JoeyShotts/GCODE_Plotter_Polargraph/ElectronicsDiagrams/Electronics.md

# Electronics
I used Nema17 stepper motors, a 9g servo, 3 Buttons, and an OLED screen. You can disable the OLED screen easily if you don't want that feature. One of the buttons is for an estop, the other two allow you to directly run some functions on the arduino, stuff like home, a specific gcode function stored on the arduino, pen up/down. etc. I recommend an Arduino Mega for this project, but an Arduino Uno would likely work, and so would another reasonably powerful microcontroller if you know what you're doing.

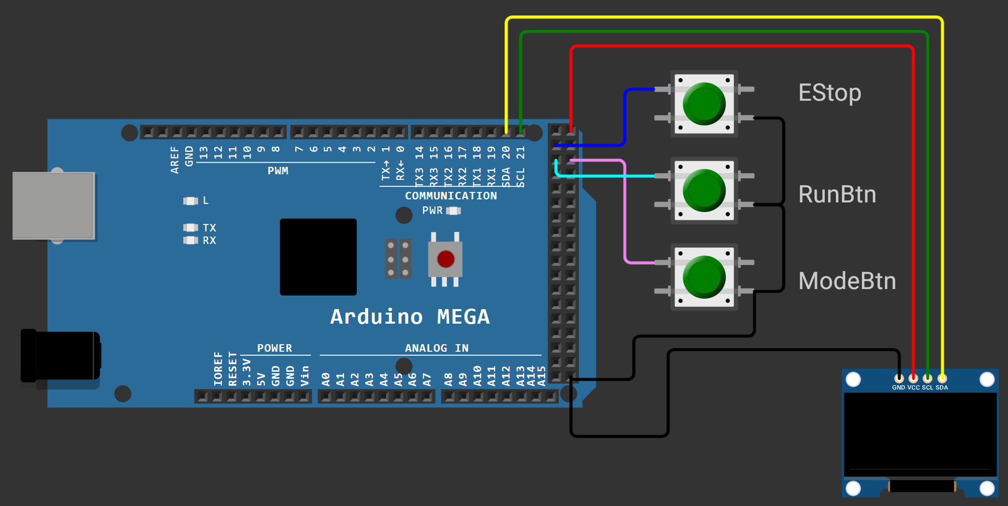
[picture p5: ElectronicsDiagrams/OLED_Buttons.png]
OLED_Buttons


## Motor Driver
This project uses a low cost motor driver. It uses nema17 motors and a knockoff of the AdafruitMotorSheildV1 (This can add some complexity). Some Nema17 motors tend to draw more current than the AdafruitMotorSheildV1 likes to provide. I wired 4 100 Ohm 1/4 watt resistors (in parallel to make 25 Ohms) in series with each coil of the nema17 motors (8 resistors per motor because there are 2 coils per motor). This is not ideal and can be avoided by using a lower current stepper motor (like the one linked below). It would also be relatively trivial to use a different motor driver update the arduino code as the accel steppers library is used. You simply need to update the functions that step each motor forward and backward.

[AdafruitMotorSheildV1 (called L293D driver) Driver](https://www.amazon.com/DiGiYes-Stepper-Expansion-Duemilanove-Raspberry/dp/B0BSN8FTH2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)

You will also need a power supply for the driver. This one is nice, I would set the input voltage to around 9v and then slowly increase as needed, keeping it less than 15v. The link has a power supply with a barrel jack, it also has an adapter with screw terminals need to connect the power supply to the motor driver.

[Barrel Jack Power for Driver](https://www.amazon.com/Adjustable-Universal-Switching-Minidodoca-Electronics/dp/B0C5QG946M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)

## Servo
I used a standard 180 degree 9g servo controlled with a PWM signal. Many motor shields have spots for these, if they don't, you can easily wire the servo directly to the arduino.The AdafruitMotorSheildV1 has a spot for a servo and I plugged in a servo to motor 1. This connects to pin 10. The servo pin and be changed in the penLift.ino file. You will need some kind of servo extenstion or 3 wires to connect the servo to the arduino.

[9g Servo Example](https://www.amazon.com/10Pcs-Servos-Helicopter-Airplane-Controls/dp/B07MLR1498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)

## Push Buttons
It has 3 physical pushbuttons (no hardware debounce or resistors needed). One is an EStop that will stop the machine at any point. Another is used to change a function, see manual functions below to get a list of the functions on the machine. The third will run the currently selected function. These give a user the ability to just run a GCODE file, without any kind of software/usb connection needed. The two change function and run function can be disabled by commenting out the macro MODE_BUTTONS.

Note where the two sides of the buttons are. One side needs to be connected to ground, the other side to a digital input of the arduino. You can change the pins in the arduino in the code easily.

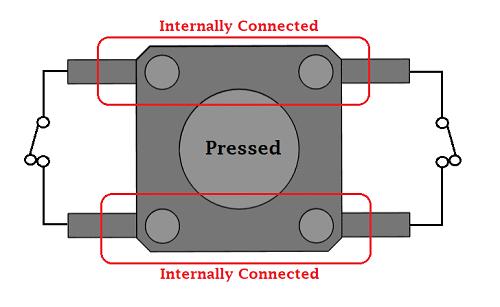
[picture p6: ElectronicsDiagrams/Push-button-Pinout.gif]
Push Button Pinout


[Push Buttons](https://www.amazon.com/Gikfun-12x12x7-3-Tactile-Momentary-Arduino/dp/B01E38OS7K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)

## Small OLED Screen
It also uses a single I2C 0.96 inch common OLED screen (128x64 pixels) to allow for some functions to be run directly on the machine. This is convenient feedback but can be easily disabled with a single MACRO (just comment out the #define OLED in the PolargraphGCODEController.ino file) in the arduino code. To wire up the OLED there are 4 pins, GND, +Vcc (typically 5 volts is preferred but 3.3 will work), SCL and SDA. SCL and SDA can only be on specific pins. Just look up the I2C pins of the microcontroller you're using. On an Arduino Mega SCL is digital pin 21 and SDA is digital pin 20.

Occasionally these OLED screens will have a different address than normal and if you've double checked the wiring and it still isn't working, check the OLED.ino file, look for the address 0x3C and change it to 0x3D.

[OLED Example Link](https://www.amazon.com/Hosyond-Display-Self-Luminous-Compatible-Raspberry/dp/B0BFD4X6YV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)

## Stepper Diagram
Different Nema17 steppers can be wired differently and have different current draws so be careful. Many have colored wires that line up with the diagram below as follows:
Green and Red are paired
Black and Blue are paired

1a: Red
2b: Blue
1b: Green
2a: Black

You can check if two wires are connected through a coil by seeing if a multimeter has no resistance over those two wires. Ex: Red and Green wires (with one wire connected to black test probe and the other connected to the red test probe) should show no resistance.

When using the AdafruitMotorSheildV1 each coil is connected to a different motor. (There are two screw terminals per motor). Ex: M1 should have 1a and 1b connected. M2 should have 2a and 2b connected. M3 might have 1a and 1b of another motor, etc.

[Stepper Motor Link](https://www.amazon.com/BESJMYT-Stepper-0-80inch-Engraving-1-66x1-66x0-81inch/dp/B0D22GZFPC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)

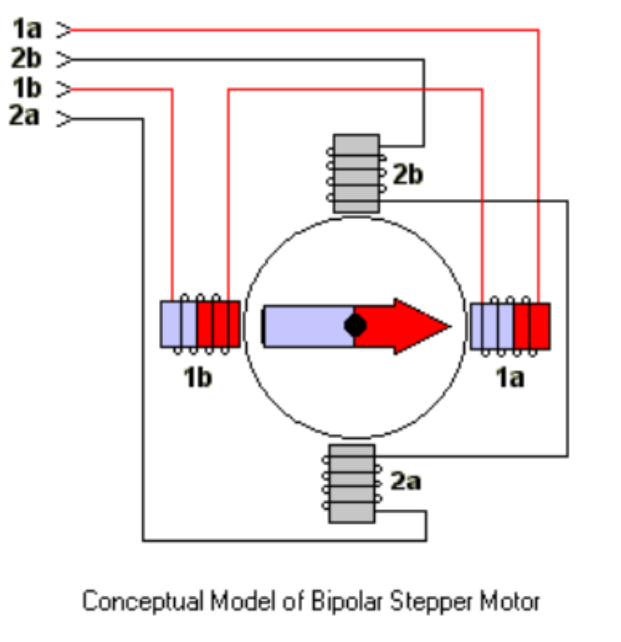
[picture p7: ElectronicsDiagrams/Nema17BipolarDiagram.png]
Nema17 Bipolar Stepper Diagram
