JoeyShotts/GCODE_Plotter_Polargraph/3D Models and Components/3D_Files/MotorBracketV5 - GongolaAlignmentClipV2.stl

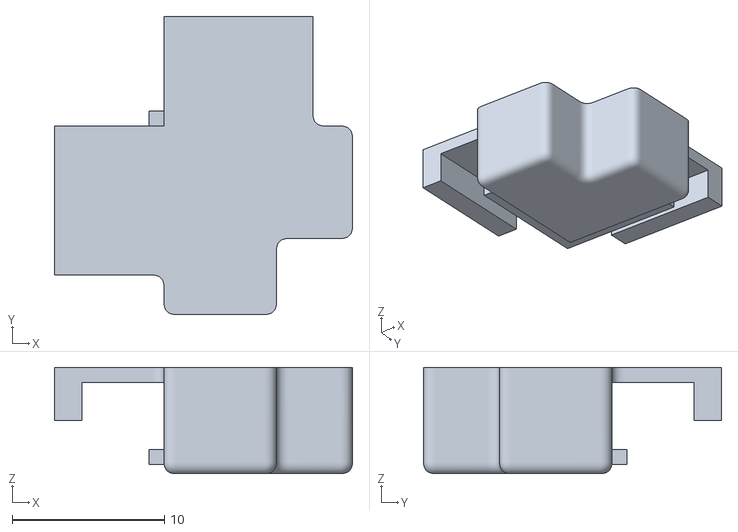
[picture p13: CAD file, 2025-09-12]
3D Models and Components/3D_Files/MotorBracketV5 - GongolaAlignmentClipV2.stl
19.6 x 19.6 x 7.00
