JoeyShotts/GCODE_Plotter_Polargraph/3D Models and Components/3D_Files/MotorBracketV5 - MotorBracketR.stl

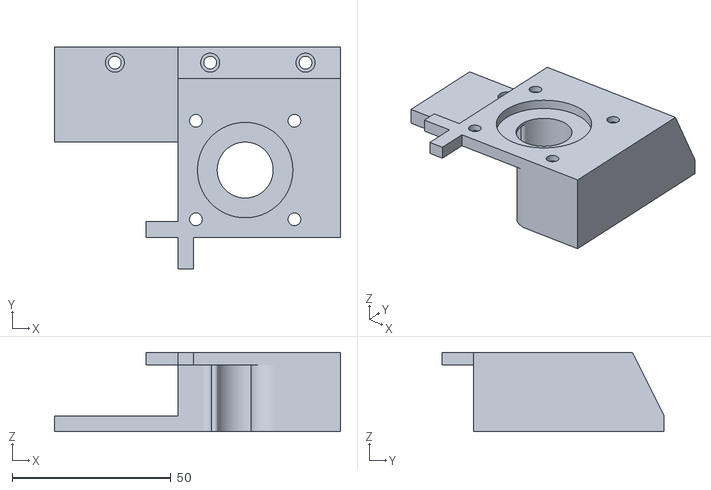
[picture p14: CAD file, 2025-06-21]
3D Models and Components/3D_Files/MotorBracketV5 - MotorBracketR.stl
90.0 x 70.0 x 25.0
