JoeyShotts/GCODE_Plotter_Polargraph/3D Models and Components/3D_Files/ElectronicsBase - Part 1.stl

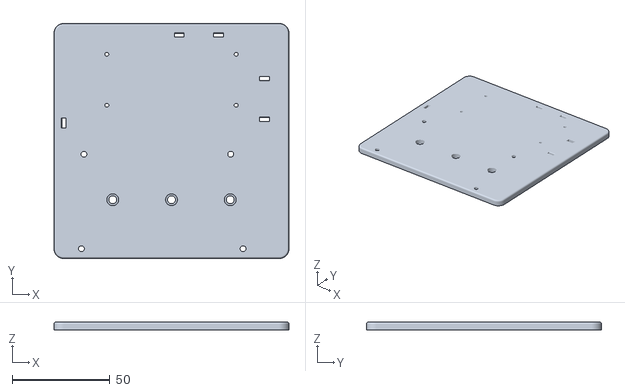
[picture p15: CAD file, 2025-06-21]
3D Models and Components/3D_Files/ElectronicsBase - Part 1.stl
120.0 x 120.0 x 4.00
