JoeyShotts/GCODE_Plotter_Polargraph/3D Models and Components/3D_Files/MotorBracketV5 - MotorClipR.stl

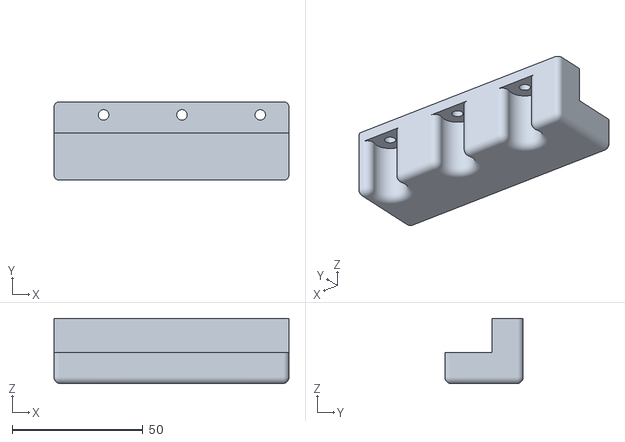
[picture p16: CAD file, 2025-06-21]
3D Models and Components/3D_Files/MotorBracketV5 - MotorClipR.stl
90.0 x 30.0 x 25.0
