JoeyShotts/GCODE_Plotter_Polargraph/3D Models and Components/3D_Files/SideWeights - PrintTwo.stl

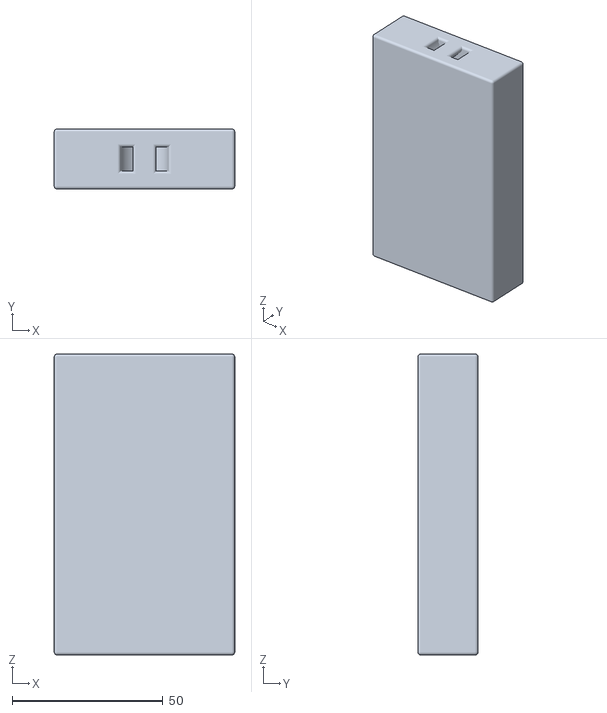
[picture p17: CAD file, 2025-06-21]
3D Models and Components/3D_Files/SideWeights - PrintTwo.stl
60.0 x 20.0 x 100.0
