JoeyShotts/GCODE_Plotter_Polargraph/3D Models and Components/3D_Files/PenHolderAdapter.stl

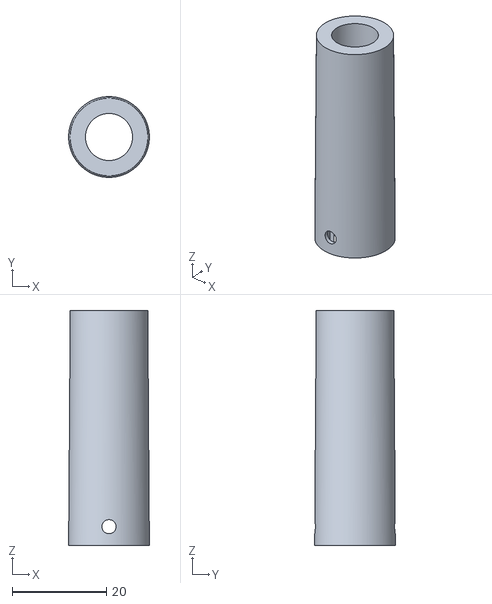
[picture p18: CAD file, 2025-06-21]
3D Models and Components/3D_Files/PenHolderAdapter.stl
17.2 x 17.2 x 50.0
