JoeyShotts/GCODE_Plotter_Polargraph/3D Models and Components/3D_Files/CenterWeight.stl

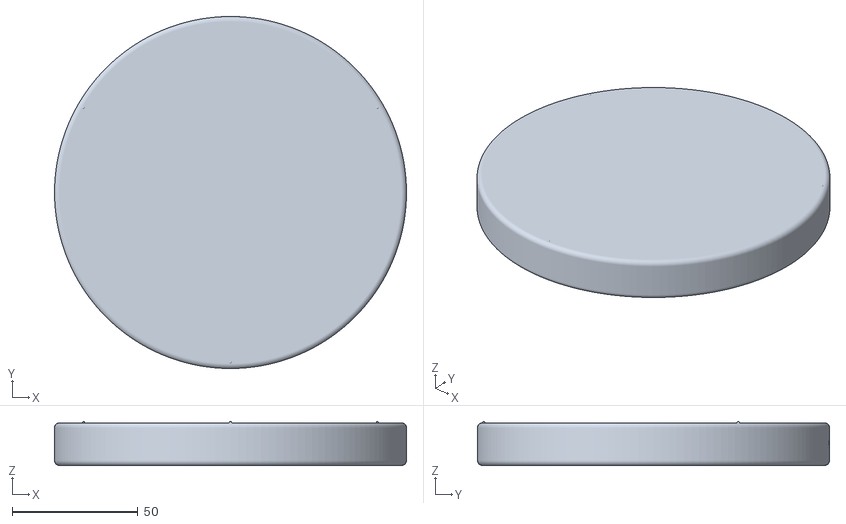
[picture p19: CAD file, 2025-06-21]
3D Models and Components/3D_Files/CenterWeight.stl
140.0 x 140.0 x 17.5
