JoeyShotts/GCODE_Plotter_Polargraph/(list of files, cad)

Other CAD files:
3D Models and Components/3D_Files/MotorBracketV5 - MotorBracketL.stl
3D Models and Components/3D_Files/MotorBracketV5 - MotorClipL.stl
