JoeyShotts/GCODE_Plotter_Polargraph/Arduino_Code/PolargraphGCODEController/gcode.ino

/*
  Short GCODE Files that are built in and can be run using the buttons.
*/

//*********************************************************************************************************************
void testGcode(){
  #ifdef TEST_GCODE
  moveHome();
  bool prevState = relativeCoords;
  relativeCoords=true;
  RapidPositioning(165.611636, -95.233065);
  penlift_penDown();
  CircularInterpolationCCW(-7.304553999999996, -13.23652100000001, 96.593466, -61.93872);        
  CircularInterpolationCCW(-5.5009780000000035, -14.081945999999988, 103.898022, -48.7022);      
  CircularInterpolationCCW(-2.2700959999999952, -9.062417999999994, 73.003684, -23.102634);      
  CircularInterpolationCCW(-0.4027420000000177, -9.258299000000022, 32.428097, -6.048554);       
  CircularInterpolationCCW(0.8487790000000075, -4.580356999999992, 27.059142, 2.645469);
  CircularInterpolationCCW(1.7019280000000094, -4.3267040000000065, 21.229841, 5.852767);        
  CircularInterpolationCCW(2.6148000000000025, -3.8506459999999834, 17.829693, 9.294223);        
  CircularInterpolationCCW(3.4832469999999773, -3.069658000000004, 12.966318, 11.202218);        
  CircularInterpolationCCW(6.574714999999998, -2.627613999999994, 9.566314, 14.397154);
  CircularInterpolationCCW(7.130388000000011, -0.03439600000001519, 3.665912, 20.862188);        
  CircularInterpolationCCW(6.762609999999995, 2.1933679999999924, -3.907788, 23.570471);
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
  LinearInterpolation(253.281011,-573.161088);
  LinearInterpolation(287.244511,-578.460332);
  LinearInterpolation(300.955701,-613.120462);
  penlift_penUp();
  RapidPositioning(0.000000,0.000000);
  relativeCoords=prevState;
  moveHome();
  #endif
}
