JoeyShotts/GCODE_Plotter_Polargraph/(commit log)

2025-06-20 Updated and simplified the arduino code
2025-06-21 Added more documentation and the build exe
    [CenterWeight.stl, ElectronicsBase - Part 1.stl, MotorBracketV5 - MotorBracketL.stl, MotorBracketV5 - MotorBracketR.stl, MotorBracketV5 - MotorClipL.stl, MotorBracketV5 - MotorClipR.stl, PenHolderAdapter.stl, SideWeights - PrintTwo.stl]
2025-06-21 More documentation
    [CenterWeight.stl, ElectronicsBase - Part 1.stl, MotorBracketV5 - MotorBracketL.stl, MotorBracketV5 - MotorBracketR.stl, MotorBracketV5 - MotorClipL.stl, MotorBracketV5 - MotorClipR.stl, PenHolderAdapter.stl, SideWeights - PrintTwo.stl]
2025-08-13 Added Start Motors
    Start Motors turns on the motors so they're at a fixed position, useful for keeping the machine in a fixed position after moving the gondola around.
    [buttons.ino, util.ino]
2025-08-13 Bug fix on new function
    [util.ino]
2025-09-12 Documentation updates
    [MotorBracketV5 - GongolaAlignmentClipV2.stl]
